CBDT-JWT/autoE_Mgun/docs/plan.md

# 项目规划
## 项目分解
```mermaid
        graph TD
        A1(智能电磁炮)-->B1[硬件]
        A1-->B2[软件]
        B1-->C1[功率系统]
        B1-->C2[信号回路]
        C1-->D1[升压电路]-->E0(ZVS/boost)
        C1-->D2[线圈回路]-->E4(IGBT关断,光电)
        C1-->D3[EMS]
        C2-->D3
        C2-->D4[机载摄像头]
        C2-->D5[手持终端]
        D5-->E1[陀螺仪]
        D5-->E2[摄像头]
        D5-->E3[显示及UI]
        B2-->C3[...]
        C2-->D6[姿态调整装置]
        C2-->D7[供弹装置等]
```
## 前期准备
### 软件下载
- 电路仿真软件 `MULTISIM14` https://cloud.tsinghua.edu.cn/d/d82f36fe9607472283ef/
- PCB设计软件 `Altisim` https://www.altium.com/ 注册账号并申请教育版
- `AutoCAD` https://www.autodesk.com.hk/products/autocad 注册账号并申请教育版
