CBDT-JWT/autoE_Mgun/docs/finalreport/imgs/progress.png

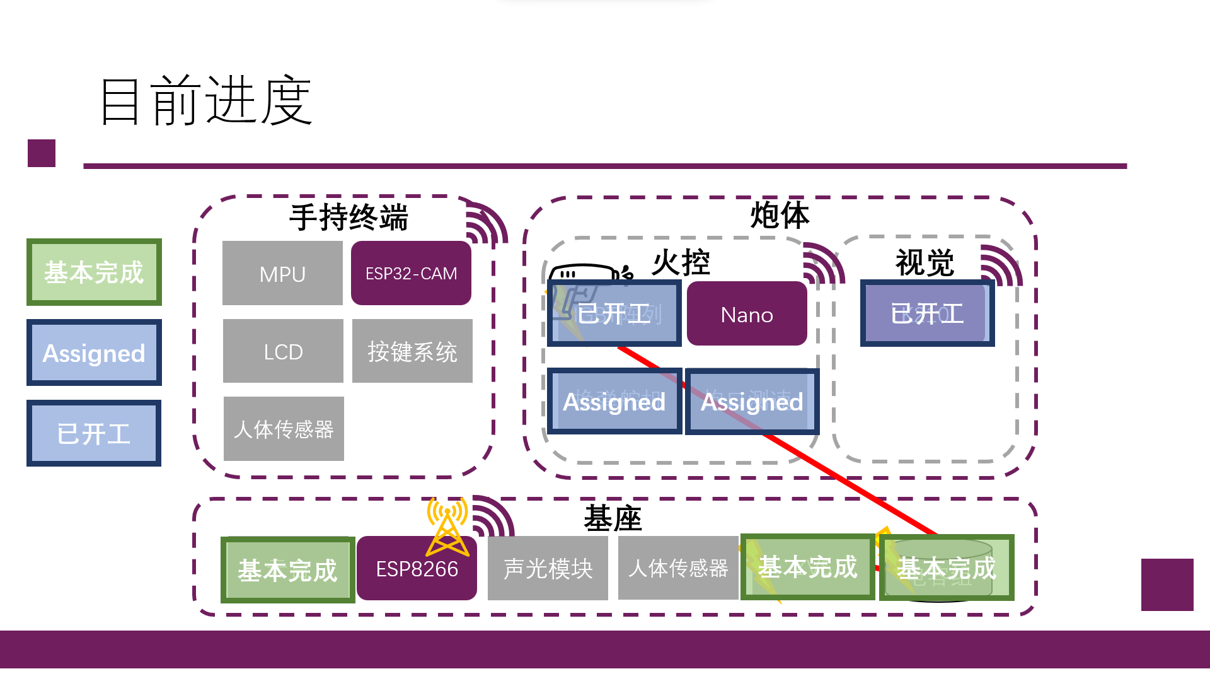
docs/finalreport/imgs/progress.png
