CBDT-JWT/autoE_Mgun/image.png

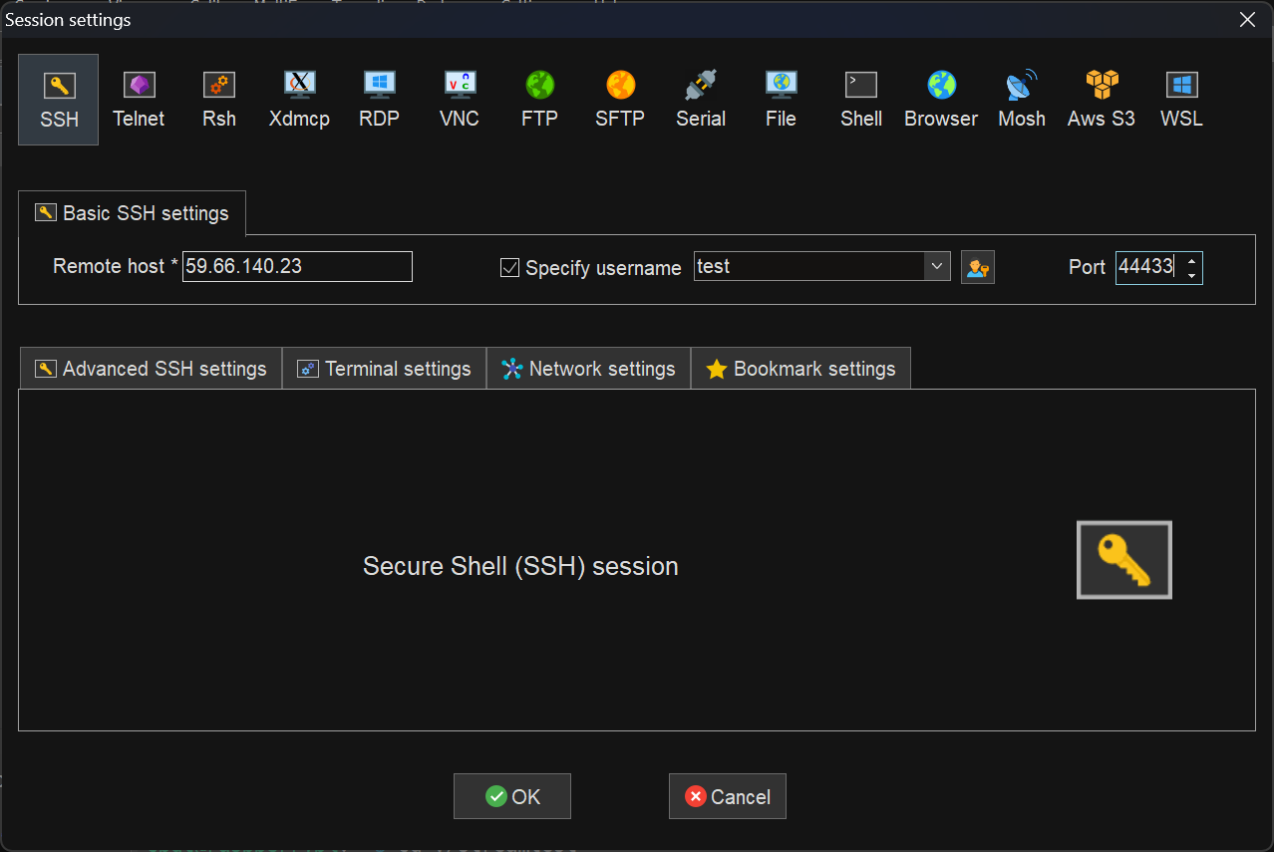
image.png
