CBDT-JWT/autoE_Mgun/img/image.png

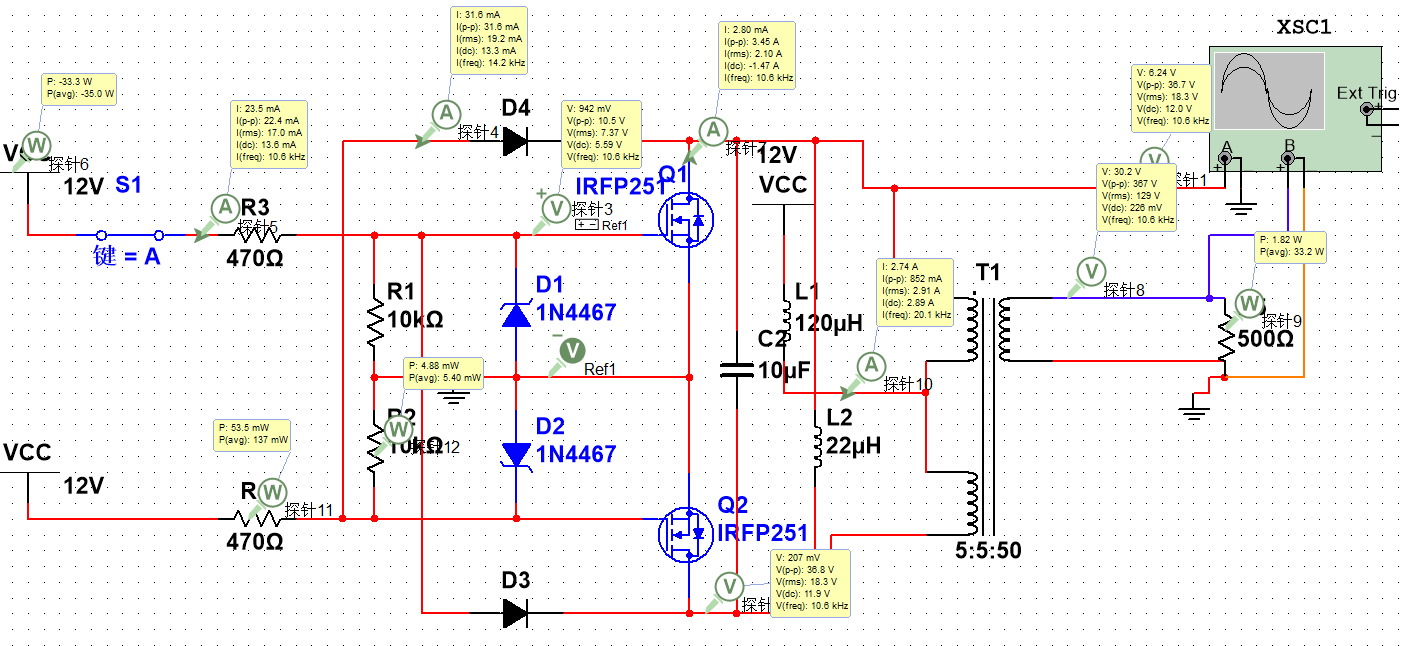
img/image.png
