CBDT-JWT/autoE_Mgun/hardware/BOM_charger with rotation_PCB2_2024-09-12.csv

No. | Quantity | Comment | Designator | Footprint | Value | Manufacturer Part | Manufacturer | Supplier Part | Supplier
1 | 1 | 330nF | C0 | CAP-TH_L18.0-W6.0-P15.00-D0.8 | 330nF | MPX334K31D2KN15800 | KNSCHA(科尼盛) | C504201 | LCSC
2 | 1 | DB128L-5.08-4P-GN-S | CN1 | CONN-TH_4P_DB128L-5.08-4P-GN-S |  | DB128L-5.08-4P-GN-S | DORABO(地博电气) | C2827883 | LCSC
3 | 2 | FR107 | D2,D3 | SOD-123FL_L2.7-W1.8-LS3.8-RD |  | FR107 | Slkor(萨科微) | C2760867 | LCSC
4 | 1 | 1N4148W | D5 | SOD-123_L2.7-W1.6-LS3.7-FD |  | 1N4148W | 宏迦橙 | C7420318 | LCSC
5 | 1 | DB107S | D6 | DBS_L8.2-W6.4-P5.10-LS10.0-BL |  | DB107S | MDD(辰达半导体) | C5377 | LCSC
6 | 2 | MM1Z5V1 | D7,D8 | SOD-123_L2.8-W1.8-LS3.7-RD |  | MM1Z5V1 | 晶导微电子 | C112534 | LCSC
7 | 1 | ZX-XH2.54-2PZZ | FAN | CONN-TH_2P-P2.50_HX25003-2A |  | ZX-XH2.54-2PZZ | Megastar(兆星) | C7429632 | LCSC
8 | 1 | 68uH | L1 | IND-TH_L21.0-W11.0-P10.00 | 68uH | SLT065125T680MTB | Sunltech(韩国顺磁) | C908340 | LCSC
9 | 1 | MV7442/QT264-7UGC | LED1 | LED-TH_BD3.0-P2.54-FD |  | MV7442/QT264-7UGC | EVERLIGHT(亿光) | C17701866 | LCSC
10 | 2 | IRFP250NPBF | Q1,Q2 | TO-247AC-3_L15.8-W5.0-P5.46-L |  | IRFP250NPBF | Infineon(英飞凌) | C2580 | LCSC
11 | 1 | LR7843-VB | Q3 | TO-252-2_L6.6-W6.1-P4.58-LS9.9-BR |  | LR7843-VB | VBsemi(微碧半导体) | C5137375 | LCSC
12 | 1 | AO3400A | Q4 | SOT-23-3_L2.9-W1.3-P1.90-LS2.4-BR |  | AO3400A | AOS | C20917 | LCSC
13 | 2 | 470Ω | R1,R2 | R1206 | 470Ω | 1206W4F4700T5E | UNI-ROYAL(厚声) | C4502 | LCSC
14 | 1 | 400Ω | R4 | R0805 | 400Ω | TR0805B400RP0525Z | EVER OHMS(天二科技) | C153298 | LCSC
15 | 3 | 1kΩ | R12,R14,R16 | R0603 | 1kΩ | RC0603FR-071KL | YAGEO(国巨) | C22548 | LCSC
16 | 1 | 10kΩ | R13 | R0603 | 10kΩ | 0603WAF1002T5E | UNI-ROYAL(厚声) | C25804 | LCSC
17 | 1 | 20Ω | R15 | RES-TH_BD4.5-L11.0-P15.00-D0.7 | 20Ω | CR1W-20Ω±5%-6T63 | VO(翔胜) | C2897143 | LCSC
18 | 1 | 10kΩ | R17 | R0603 | 10kΩ | FRC0603J103TS | FOJAN(富捷) | C2930027 | LCSC
19 | 1 | 500Ω | R18 | RES-TH_BD9.0-L31.5-P35.50-D0.8 | 500Ω | EWWR0008J500RT9 | RESI(开步睿思) | C349059 | LCSC
20 | 1 | 47kΩ | R19 | R0603 | 47kΩ | 0603WAF4702T5E | UNI-ROYAL(厚声) | C25819 | LCSC
21 | 1 | 100kΩ | R20 | RES-ADJ-TH_3P-L9.5-W4.9-P2.50-L_3296W | 100kΩ | 3296W-1-104 | BOCHEN(博晨) | C118963 | LCSC
22 | 1 | 20kΩ | R21 | RES-ADJ-TH_3P-L10.0-W10.0-P2.50-BL-BS | 20kΩ | 3296W-1-203 | BOCHEN(博晨) | C118936 | LCSC
23 | 1 | 100kΩ | R22 | R0603 | 100kΩ | 0603WAF1003T5E | UNI-ROYAL(厚声) | C25803 | LCSC
24 | 1 | EC49 | T1 | XFMR-TH_16P-L40.0-W40.0-P5.00-LS35.0-BL |  | EC49 |  | C9900117156 | LCSC
25 | 1 | PC817X1NIP0F | U2 | OPTO-SMD-4_L4.6-W6.5-P2.54-LS10.3-BL |  | PC817X1NIP0F | SHARP(夏普) | C95783 | LCSC
26 | 2 | 23.5*16*25 | U3,U4 | HEATSINK-TH_L23.5-W16.0-P18.0_XSD2156-067 |  | 23.5*16*25 | XSD(鑫顺达) | C4661 | LCSC
27 | 1 | OPA2277UA/2K5 | U6 | SOIC-8_L5.0-W4.0-P1.27-LS6.0-BL |  | OPA2277UA/2K5 | TI(德州仪器) | C24460 | LCSC
28 | 1 | 2.54-3P接线端子 | U7 | CONN-TH_2.54-3P |  | 2.54-3P接线端子 | BOOMELE(博穆精密) | C68305 | LCSC
