CBDT-JWT/autoE_Mgun/circuits/coildriver/BOM_driver_PCB1_2024-08-06.xlsx

No. | Quantity | Comment | Designator | Footprint | Value | Manufacturer Part | Manufacturer | Supplier Part | Supplier
1 | 12 | 1uF | C12,C13,C50,C51,C53,C54,C56,C57,C59,C60,C62,C63 | C0603 | 1uF | CL10A105KB8NNNC | SAMSUNG(三星) | C15849 | LCSC
2 | 6 | 22uF | C14,C52,C55,C58,C61,C64 | C0603 | 22uF | CL10A226MQ8NRNC | SAMSUNG(三星) | C59461 | LCSC
3 | 1 | DB128V-5.08-4P-GN-S | CN1 | CONN-TH_4P-P5.08_DIBO_DB128V-5.08 |  | DB128V-5.08-4P-GN-S | DORABO(地博电气) | C2915641 | LCSC
4 | 6 | 1N5355BG | D23,D60,D69,D78,D87,D96 | DO-201_BD5.3-L9.5-P13.50-D1.4-RD |  | 1N5355BG | onsemi(安森美) | C232448 | LCSC
5 | 12 | VS-75EPU12L-N3 | D24,D25,D61,D62,D70,D71,D79,D80,D88,D89,D97,D98 | TO-247-2_L15.8-W5.0-P10.92-L |  | VS-75EPU12L-N3 | VISHAY(威世) | C335787 | LCSC
6 | 26 | 1N4001 | D26,D48,D49,D50,D65,D66,D67,D68,D74,D75,D76,D77,D83,D84,D85,D86,D92,D93,D94,D95,D101,D102,D103,D104,D105,D106 | SMA_L4.3-W2.5-LS5.0-RD |  | 1N4001 | TWGMC(台湾迪嘉) | C727079 | LCSC
7 | 12 | 1N4148W | D27,D28,D63,D64,D72,D73,D81,D82,D90,D91,D99,D100 | SOD-123_L2.7-W1.6-LS3.7-FD |  | 1N4148W | 宏迦橙 | C7420318 | LCSC
8 | 4 | KH-2.54FH-1X15P-H8.5 | ESP8266_LHS,ESP8266_LHS1,ESP8266_RHS,ESP8266_RHS1 | HDR-TH_15P-P2.54-V-F |  | KH-2.54FH-1X15P-H8.5 | kinghelm(金航标) | C2932676 | LCSC
9 | 12 | 5.1Ω | R24,R25,R41,R42,R43,R44,R45,R46,R47,R48,R49,R50 | R1206 | 5.1Ω | FRC1206F5R10TS | FOJAN(富捷) | C2933736 | LCSC
10 | 6 | IR2110SPBF | U20,U43,U47,U51,U55,U59 | SOIC-16_L10.3-W7.5-P1.27-LS10.3-BL |  | IR2110SPBF | Infineon(英飞凌) | C537554 | LCSC
11 | 12 | AUIRGPS4067D1 | U21,U22,U44,U45,U48,U49,U52,U53,U56,U57,U60,U61 | SUPER-247_L15.6-W5.0-P5.45-L |  | AUIRGPS4067D1 |  | C9900044144 | LCSC
12 | 6 | WJ350V-3.96-2P-14-00A | U23,U46,U50,U54,U58,U62 | CONN-TH_2P-P3.96_WJ350V-3.96-2P-14-00A |  | WJ350V-3.96-2P-14-00A | KANGNEX(康奈克斯电气) | C3031444 | LCSC
