CBDT-JWT/autoE_Mgun/hardware/装配体1.SLDASM

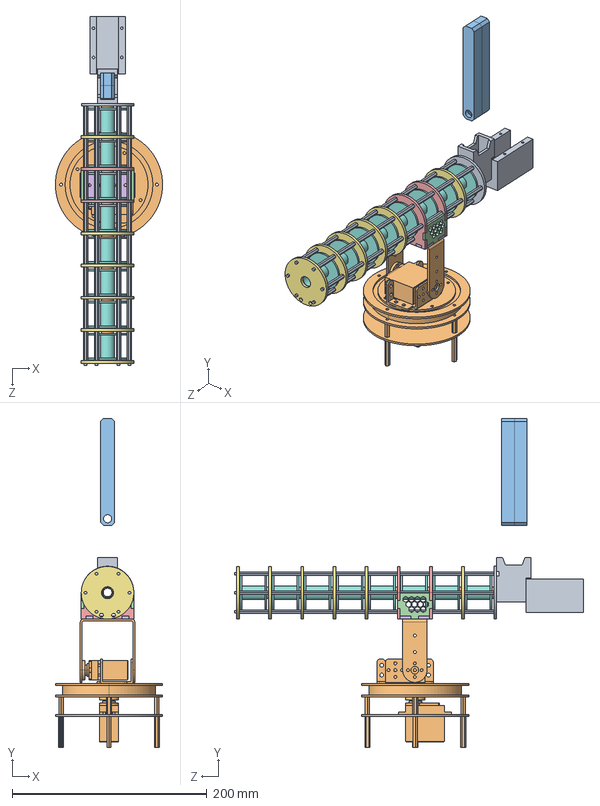
[picture p21: CAD file, 2024-07-27]
hardware/装配体1.SLDASM
110.0 x 337.8 x 358.0 mm
tube
铜柱M3_30+5 x 48
coilskeleton x 8
coilholder_0 x 6
coilholder_3
coilholder_1 x 2
coilholder_2 x 2
magazine_1 x 2
二自由度云台
loader
