CBDT-JWT/autoE_Mgun/hardware/pcbholder.SLDPRT

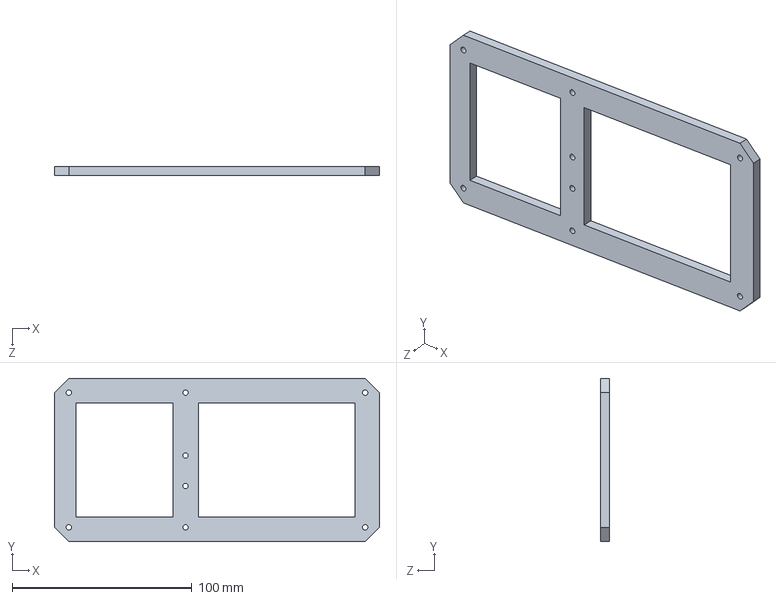
[picture p22: CAD file, 2024-09-10]
hardware/pcbholder.SLDPRT
181.0 x 91.0 x 5.00 mm
