CBDT-JWT/autoE_Mgun/hardware/magazine000.STL

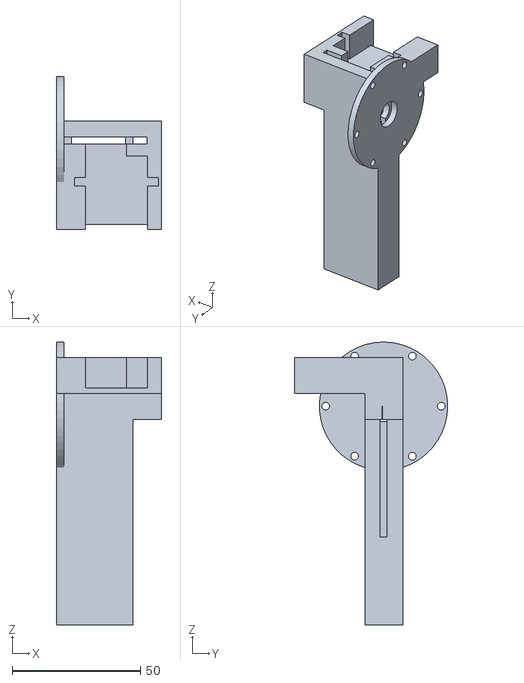
[picture p23: CAD file, 2024-09-10]
hardware/magazine000.STL
40.9 x 59.7 x 110.2
