CBDT-JWT/autoE_Mgun/hardware/coilholder_0.SLDPRT

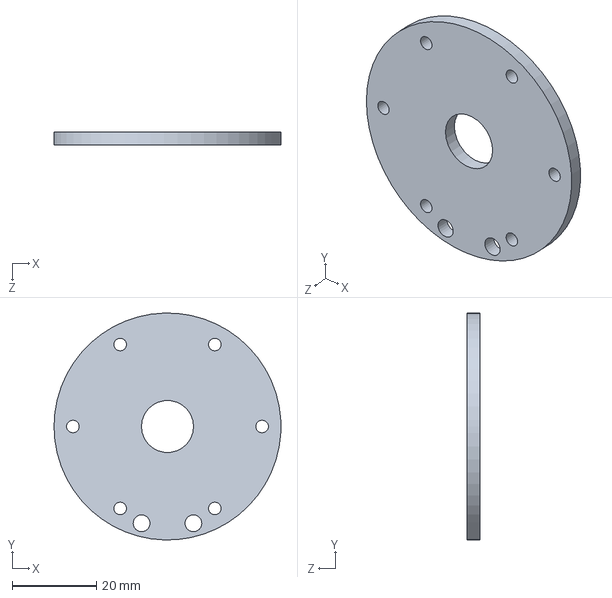
[picture p24: CAD file, 2024-09-10]
hardware/coilholder_0.SLDPRT
54.0 x 54.0 x 3.00 mm
