CBDT-JWT/autoE_Mgun/hardware/camera_holder.SLDPRT

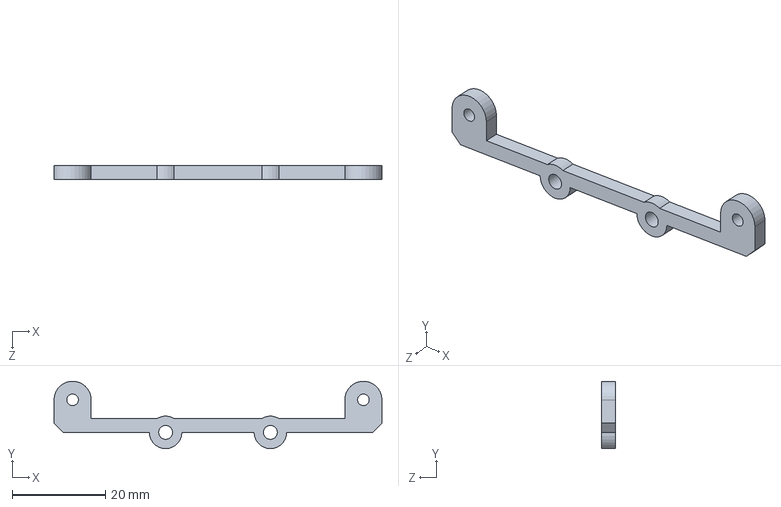
[picture p25: CAD file, 2024-08-30]
hardware/camera_holder.SLDPRT
70.5 x 14.5 x 3.00 mm
