CBDT-JWT/autoE_Mgun/hardware/basesmall.STL

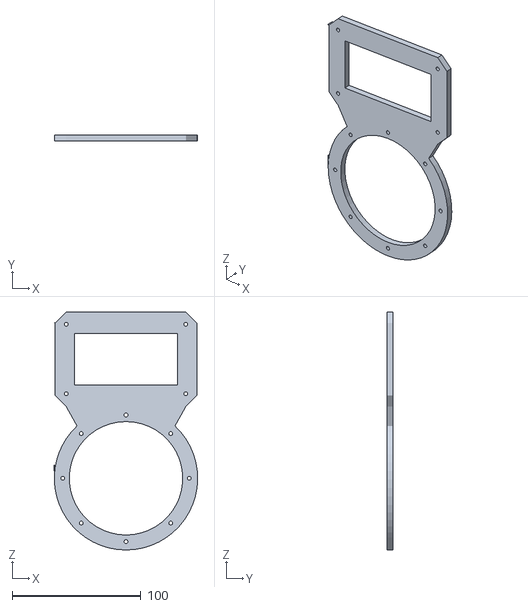
[picture p26: CAD file, 2024-08-30]
hardware/basesmall.STL
111.2 x 5.00 x 184.6
