CBDT-JWT/autoE_Mgun/hardware/零件1.SLDPRT

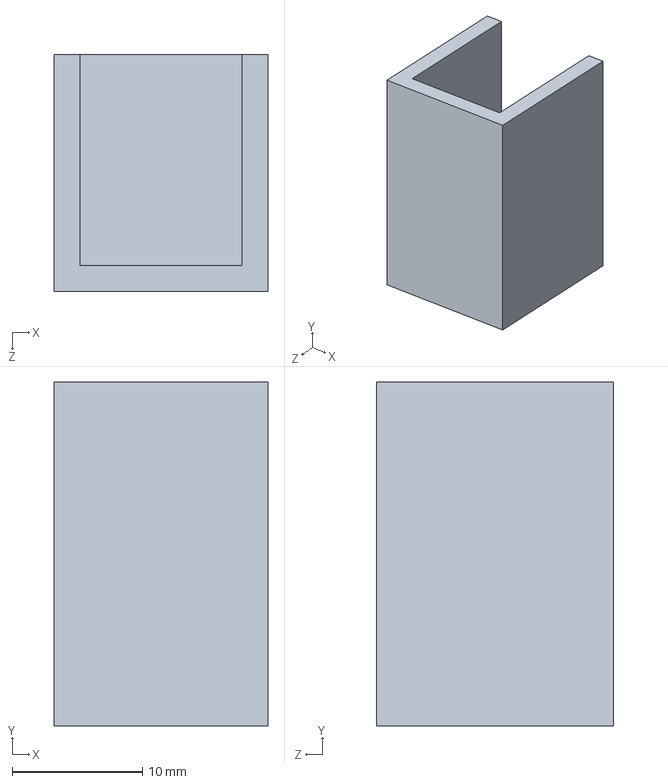
[picture p27: CAD file, 2024-08-30]
hardware/零件1.SLDPRT
16.4 x 26.4 x 18.2 mm
