CBDT-JWT/autoE_Mgun/hardware/tube.SLDPRT

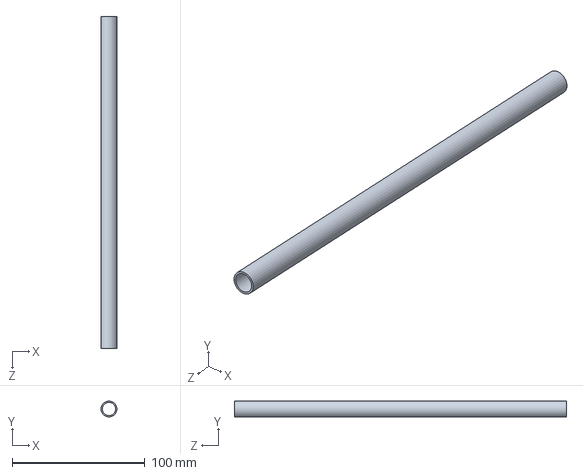
[picture p28: CAD file, 2024-08-06]
hardware/tube.SLDPRT
12.0 x 12.0 x 250.0 mm
