CBDT-JWT/autoE_Mgun/hardware/magazine_1.SLDPRT

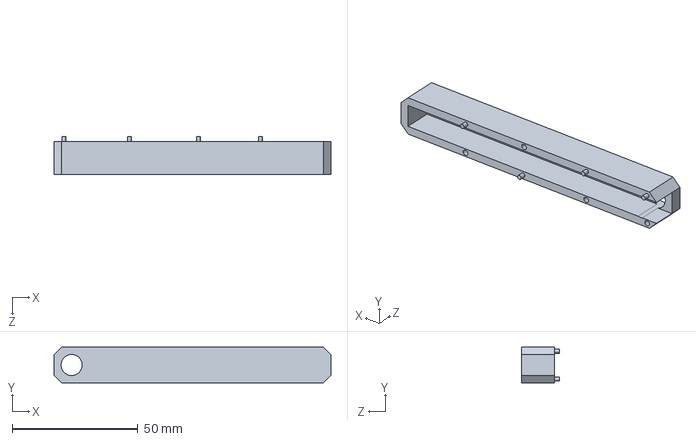
[picture p29: CAD file, 2024-07-27]
hardware/magazine_1.SLDPRT
110.0 x 14.2 x 15.0 mm
