CBDT-JWT/autoE_Mgun/hardware/coilskeleton.SLDPRT

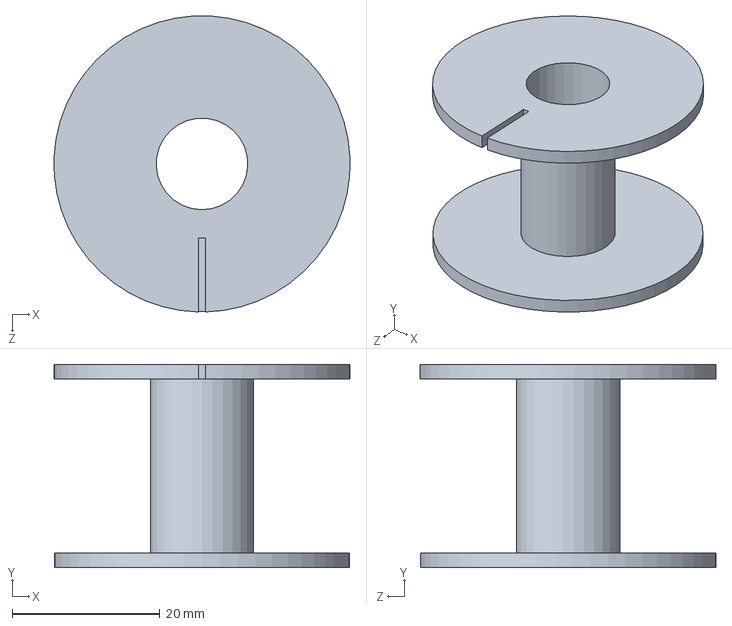
[picture p30: CAD file, 2024-07-27]
hardware/coilskeleton.SLDPRT
40.1 x 27.5 x 40.1 mm
