CBDT-JWT/autoE_Mgun/hardware/coilholder_1.SLDPRT

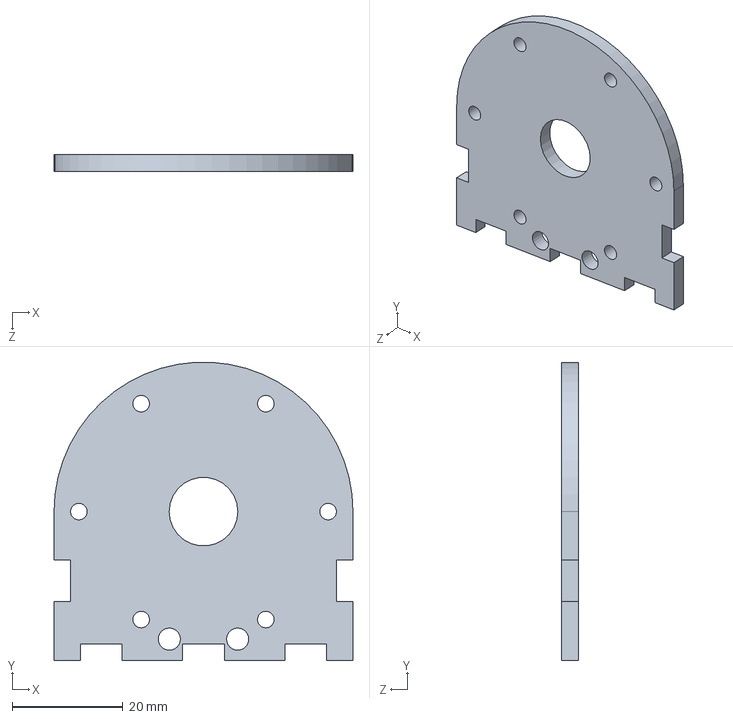
[picture p31: CAD file, 2024-07-27]
hardware/coilholder_1.SLDPRT
54.0 x 53.9 x 3.00 mm
