CBDT-JWT/autoE_Mgun/hardware/二自由度云台.SLDPRT

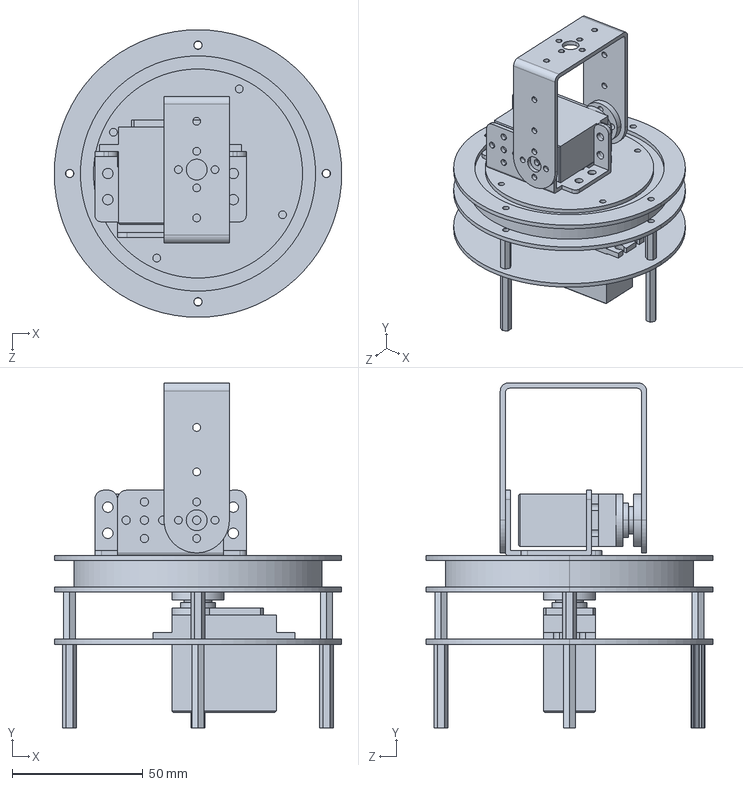
[picture p32: CAD file, 2024-07-27]
hardware/二自由度云台.SLDPRT
110.0 x 132.0 x 110.0 mm
