CBDT-JWT/autoE_Mgun/hardware/coilholder_2.SLDPRT

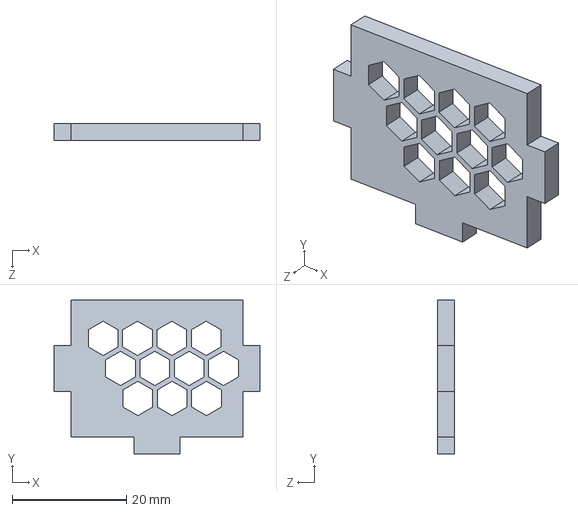
[picture p33: CAD file, 2024-07-27]
hardware/coilholder_2.SLDPRT
36.0 x 26.9 x 3.00 mm
