CBDT-JWT/autoE_Mgun/hardware/铜柱M3_30+5.SLDPRT

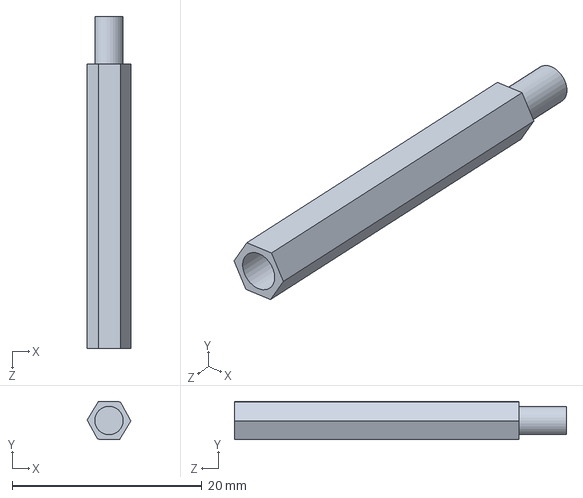
[picture p34: CAD file, 2024-07-27]
hardware/铜柱M3_30+5.SLDPRT
4.62 x 4.05 x 35.0 mm
