CBDT-JWT/autoE_Mgun/hardware/coilholder.SLDPRT

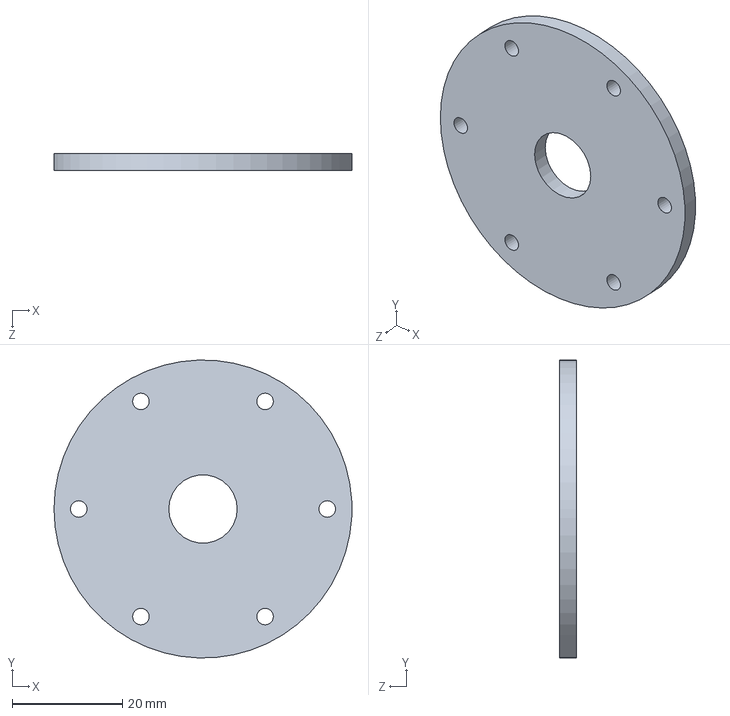
[picture p35: CAD file, 2024-07-27]
hardware/coilholder.SLDPRT
54.0 x 54.0 x 3.00 mm
