CBDT-JWT/autoE_Mgun/hardware/coilholder_3.SLDPRT

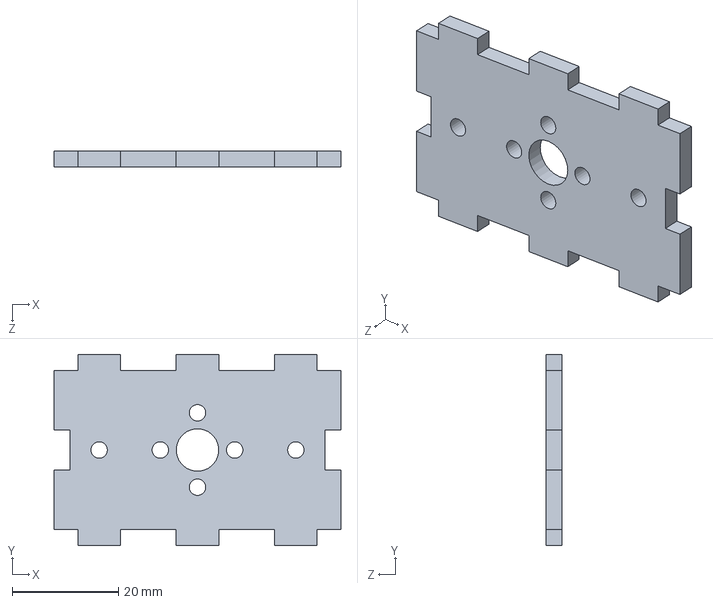
[picture p36: CAD file, 2024-07-27]
hardware/coilholder_3.SLDPRT
54.0 x 36.0 x 3.00 mm
