CBDT-JWT/autoE_Mgun/hardware/loader.SLDPRT

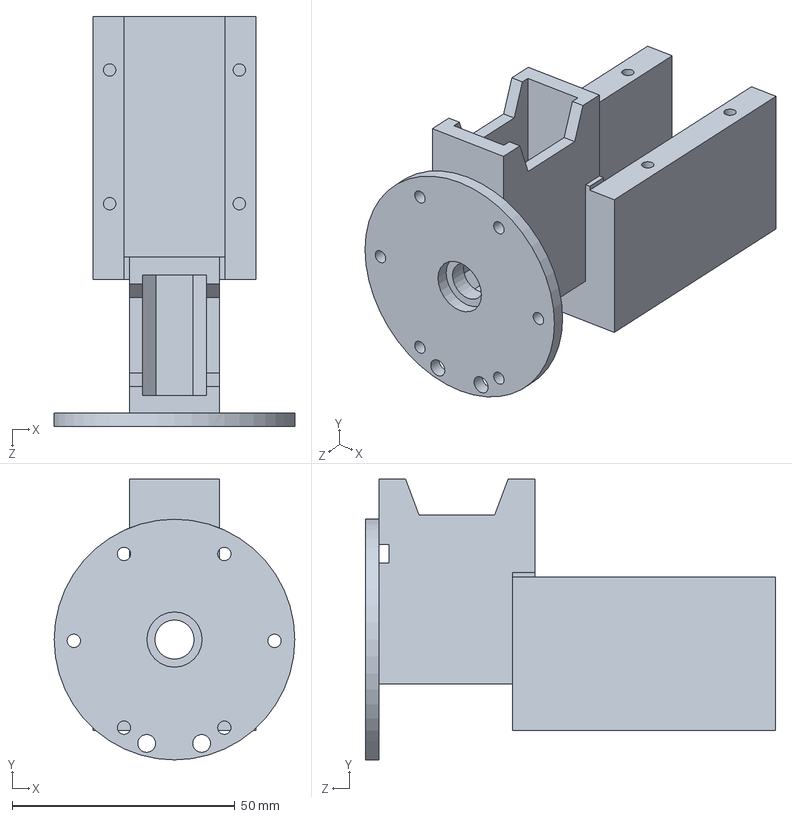
[picture p37: CAD file, 2024-07-27]
hardware/loader.SLDPRT
54.0 x 63.0 x 92.0 mm
