CBDT-JWT/autoE_Mgun/(list of files, cad)

Other CAD files:
hardware/base.SLDPRT
hardware/零件14.SLDPRT
hardware/base.3mf
hardware/base.STL
hardware/camera_holder.STL
hardware/coilholder.dwg
hardware/coilholder.dxf
hardware/coilholder_0.dwg
hardware/coilholder_1.dwg
hardware/coilholder_2.dwg
hardware/coilholder_3.dwg
hardware/coilskeleton.STL
hardware/loader.STL
hardware/magazine_1.3mf
hardware/magazine_1.STL
hardware/pcbholder.3mf
hardware/pcbholder.STL
