CBDT-JWT/autoE_Mgun/(list of files, drawings)

Other design files:
circuits/coildriver/coildriver.eprj
circuits/coildriver_new.eprj
circuits/driver.ms14
circuits/vbr.ms14
circuits/ZVS.ms14
circuits/设计1.ms14
