CBDT-JWT/autoE_Mgun/(commit log)

2024-06-22 add: zvs circuit
    [ZVS.ms14]
2024-06-23 add :zvs circuit
    [ZVS.ms14]
2024-06-24 bom for zvs
2024-07-27 hardware update
    [coildriver.eprj, coilholder.SLDPRT, coilholder.dwg, coilholder.dxf, coilholder_0.SLDPRT, coilholder_0.dwg, coilholder_1.SLDPRT, coilholder_1.dwg]
2024-08-03 add folder: Base
    [coildriver.eprj, driver.ms14]
2024-08-04 servo ctrl
2024-08-05 完善舵机控制
2024-08-06 add: wifi config of base
    [BOM_driver_PCB1_2024-08-06.xlsx, PickAndPlace_PCB1_2024-08-06.xlsx, coildriver.eprj, tube.SLDPRT]
2024-08-11 big fix
    [coildriver.eprj]
2024-08-12 PID done!
2024-08-30 update：circuits
    [base.3mf, base.SLDPRT, base.STL, basesmall.STL, camera_holder.SLDPRT, camera_holder.STL, coildriver.eprj, coildriver_new.eprj]
2024-08-30 update：serial control
2024-09-21 忘改标题了，草
